konstantint/BreadboardBot/code/circuitpython/dev/README.md

# BreadboardBot code (ongoing development)

The current collection of BreadboardBot code examples.

Developed / tested with [CircuitPython 7](https://adafruit-circuit-python.s3.amazonaws.com/bin/seeeduino_xiao_rp2040/en_GB/adafruit-circuitpython-seeeduino_xiao_rp2040-en_GB-7.3.3.uf2) ([library bundle](https://github.com/adafruit/Adafruit_CircuitPython_Bundle/releases/download/20231003/adafruit-circuitpython-bundle-7.x-mpy-20231003.zip)).
