konstantint/BreadboardBot/code/circuitpython/examples/README.md

# BreadboardBot - Example programs

Developed / tested with [CircuitPython 7](https://adafruit-circuit-python.s3.amazonaws.com/bin/seeeduino_xiao_rp2040/en_GB/adafruit-circuitpython-seeeduino_xiao_rp2040-en_GB-7.3.3.uf2) ([library bundle](https://github.com/adafruit/Adafruit_CircuitPython_Bundle/releases/download/20231003/adafruit-circuitpython-bundle-7.x-mpy-20231003.zip)).

The default example (in `code.py`) only uses the servos, the LED and the RGB LED. The robot just sort-of wanders around aimlessly while showing a rainbow effect ([video](https://www.youtube.com/watch?v=gX162mp3CMo)). It is intended for testing the [initial assembly](http://konstantint.github.io/BreadboardBot/assembly). 

Other scripts rely on sensors and wiring described in the [Examples](http://konstantint.github.io/BreadboardBot/examples) documentation.
