konstantint/BreadboardBot/docs/examples.md

# BreadboardBot example projects

## Starter experiments

* **Xiao RP2040**
  * [Basic line follower](examples/line_follower.md)
  * [Sonar-based obstacle-avoiding line-follower](examples/line_follower_sonar.md)
  * [Sonar-based obstacle-avoiding line-follower with a button & a buzzer](examples/line_follower_sonar_button_buzzer.md)
  * [Sonar-based obstacle-avoiding line-follower with an RGB LED matrix](examples/xiao_rgb_matrix.md)
  * [Line follower with an OLED face](examples/line_follower_oled.md)
  * [Line follower with an OLED face that shows temperature and humidity](examples/line_follower_oled_dht11.md)
  * [Line follower with an OLED screen that shows current date and time](examples/line_follower_oled_ds3231.md)
  * [IR-based obstacle-avoiding line-follower with an OLED face](examples/line_follower_oled_ir.md)
  * [Remote control using Bluetooth serial (HC05/06)](examples/oled_bluetooth.md)
  * [Self-balancing with MPU-6050 and Bluetooth serial](examples/self_balancing_bt.md)

## Other microcontrollers

* **Xiao ESP32S3(-Sense)**
  * [Web-based control over Wifi & camera](examples/esp32s3_http_control.md)
  * [Web-based control over Wifi & camera (Arduino)](examples/esp32s3sense_webfpv.md)
  * [Bluetooth gamepad steering (Arduino)](examples/bluepad32.md)
* **M5Stack Atom Lite**
  * [Line follower (ESPHome)](examples/m5atom_line_follower.md)
  * [Bluetooth gamepad steering (Arduino)](examples/bluepad32.md)

## Alternative assemblies

  * [Line follower with DC motors](examples/hbridge_line_follower.md)
  * [Self-balancing on DC Motors](examples/hbridge_self_balancing.md)
