konstantint/BreadboardBot/code/arduino/Bluepad/config.h

// Uncomment this for the M5ATOM version
// #define BOARD_M5ATOM

// Uncomment this for the GEEKSERVO motors
// (default are SG90)
// #define MOTORS_GEEKSERVO

// Uncomment for DC motors (rather than continuous servos)
// #define MOTORS_DC
