konstantint/BreadboardBot/code/circuitpython/buzzer-workshop/original_examples/mp3.py

import board
import digitalio

from audiomp3 import MP3Decoder

try:
    from audioio import AudioOut
except ImportError:
    try:
        from audiopwmio import PWMAudioOut as AudioOut
    except ImportError:
        pass  # not always supported by every board!

button = digitalio.DigitalInOut(board.D1)
button.switch_to_input(pull=digitalio.Pull.UP)

# The listed mp3files will be played in order
mp3files = ["happy.mp3"]

# You have to specify some mp3 file when creating the decoder
mp3 = open(mp3files[0], "rb")
decoder = MP3Decoder(mp3)
audio = AudioOut(board.A3)

while True:
    for filename in mp3files:
        # Updating the .file property of the existing decoder
        # helps avoid running out of memory (MemoryError exception)
        decoder.file = open(filename, "rb")
        audio.play(decoder)
        print("playing", filename)

        # This allows you to do other things while the audio plays!
        while audio.playing:
            pass

        print("Waiting for button press to continue!")
        while button.value:
            pass
