konstantint/BreadboardBot/code/circuitpython/examples/breadboardbot/platform_rp2040.py

import adafruit_dht
import adafruit_hcsr04
import adafruit_mpu6050
from adafruit_led_animation.animation.rainbow import Rainbow
import board
import busio
from digitalio import DigitalInOut, Direction
import keypad
import math
import neopixel
import pwmio
import time
from breadboardbot import motors


class Robot:
    """Primary Xiao RP2040-based BreadboardBot platform definition."""

    def __init__(
        self,
        line_sensors=True,
        sonar=False,
        dht11=False,
        i2c=False,
        mpu=False,
        uart=False,
        buzzer=False,
        motor_right_pin=board.D6,
        # Select the model of the motors attached
        # either FS90R or GEEKSERVO
        motors_model=motors.MotorsModel.FS90R
        # motors_model = motors.MotorsModel.GEEKSERVO
    ):
        self.led = DigitalInOut(board.LED_GREEN)
        self.led.direction = Direction.OUTPUT
        self.led_blue = DigitalInOut(board.LED_BLUE)
        self.led_blue.direction = Direction.OUTPUT
        self.led_blue.value = True
        self.led_red = DigitalInOut(board.LED_RED)
        self.led_red.direction = Direction.OUTPUT
        self.led_red.value = True
        self.keys = keypad.Keys((board.D1,), value_when_pressed=False, pull=True)
        self.motors = motors.ContinuousServoMotors(
            board.D0, motor_right_pin, motors_model
        )
        if line_sensors:
            self.line_left = DigitalInOut(board.D10)
            self.line_right = DigitalInOut(board.D7)
        if sonar:
            self.sonar = adafruit_hcsr04.HCSR04(
                trigger_pin=board.D4, echo_pin=board.D3, timeout=0.05
            )
        if dht11:
            self.dht11 = adafruit_dht.DHT11(board.D8)
        if uart:
            self.uart = busio.UART(board.TX, board.RX, baudrate=9600, timeout=0.1)
        if i2c or mpu:
            # SDA=D4, SCL=D5
            self.i2c = board.I2C()
        if mpu:
            self.mpu = adafruit_mpu6050.MPU6050(self.i2c)
        self.rgb_pixel = neopixel.NeoPixel(board.NEOPIXEL, 1, brightness=0.1)
        self.rainbow = Rainbow(self.rgb_pixel, speed=0.1, period=2)
        self.last_sonar_measurement_time = -1
        self.last_sonar_measurement = None
        if buzzer:
            self.buzzer_pin = board.D9
            self.buzzer_pwm = pwmio.PWMOut(
                self.buzzer_pin, frequency=1000, variable_frequency=True
            )
        self.buzzer_off_time = None
        self.led_off_time = None
        self.now = time.monotonic()

        # Welcome triple-blink / beep
        for i in range(3):
            self.blink()
            if buzzer:
                self.beep()
            self.sleep(0.1)

    def update(self):
        self.now = time.monotonic()
        if self.buzzer_off_time and self.now >= self.buzzer_off_time:
            self.buzzer_pwm.duty_cycle = 0
            self.buzzer_off_time = None
        if self.led_off_time and self.now >= self.led_off_time:
            self.led.value = True
            self.led_off_time = None

    def play_melody(self, melody):
        """Plays melody (blocking)."""
        for note, duration in melody:
            if note > 0:
                self.beep(int(note))
            self.sleep(duration)

    def beep(self, frequency=1000):
        self.buzzer_pwm.frequency = frequency
        self.buzzer_pwm.duty_cycle = 2**15
        self.buzzer_off_time = self.now + 0.05

    def blink(self):
        self.led.value = False
        self.led_off_time = self.now + 0.05

    def sleep(self, duration):
        now = self.now
        while self.now < now + duration:
            self.update()

    def get_sonar_distance(self):
        if (
            self.last_sonar_measurement is None
            or (self.now - self.last_sonar_measurement_time) > 0.1
        ):
            self.last_sonar_measurement_time = self.now
            try:
                self.last_sonar_measurement = self.sonar.distance
            except RuntimeError:
                # Do not crash on errors from sonar, which sometimes happen
                self.last_sonar_measurement = None
        return self.last_sonar_measurement

    def loop_forever(self, behaviors):
        while True:
            self.update()
            for b in behaviors:
                b(self)
