konstantint/BreadboardBot/code/circuitpython/examples/code.py

import ex01_just_wandering
# import ex02_line_follower
# import ex03_line_follower_sonar
# import ex04_line_follower_sonar_button_buzzer
# import ex05_line_follower_oled
# import ex06_line_follower_oled_dht11
# import ex07_line_follower_oled_ds3231
# import ex08_line_follower_oled_ir
# import ex09_oled_bt
# import ex10_rgb_matrix
# import ex11_self_balancing_bt
# import esp32s3_http_control
# import esp32s3sense_http_control_cam
# import hbridge_ex01_just_wandering
# import hbridge_ex02_line_follower
# import hbridge_ex03_self_balancing
