konstantint/BreadboardBot/code/circuitpython/examples/breadboardbot/melodies.py

RONDO_ALLA_TURCA = [
    (493.88, 0.1),
    (440, 0.1),
    (415.30, 0.1),
    (440, 0.1),
    (523.25, 0.2),
    (-1, 0.2),
    (587.33, 0.1),
    (523.25, 0.1),
    (493.88, 0.1),
    (523.25, 0.1),
    (659.25, 0.2),
    (-1, 0.2),
    (698.46, 0.1),
    (659.25, 0.1),
    (622.25, 0.1),
    (659.25, 0.1),
    (987.77, 0.1),
    (880.00, 0.1),
    (830.61, 0.1),
    (880.00, 0.1),
    (987.77, 0.1),
    (880.00, 0.1),
    (830.61, 0.1),
    (880.00, 0.1),
    (1046.50, 0.2),
    (-1, 0.2),
]
