konstantint/BreadboardBot/(commit log)

2023-12-29 Move examples over to `circuitpython` directory.
2023-12-30 Bluepad32 example project (for M5Atom and Xiao ESP32S3).
2024-01-01 Use correct pulse widths for SG90 and Geekservo motors. Alternative linefollower wiring diagram.
    [Robot.cpp, Robot.h, behaviors.py, config.h, esp32s3sense_http_control_cam.py, ex01_just_wandering.py, motors.py, platform_esp32s3.py]
2024-01-01 Arduino-based WebFPV example.
2024-01-07 Upgrade examples to CircuitPython 8.
2024-01-12 BreadboardBot - DC motor version.
2024-01-15 Minor edits to assembly instructions.
